AA-CubeSat-Team/soci_img/src-no_thumbnail/README.md

# Current version v0.0.0

## Release History
