AA-CubeSat-Team/soci_img/FreeVector-Color-Grid.jpg

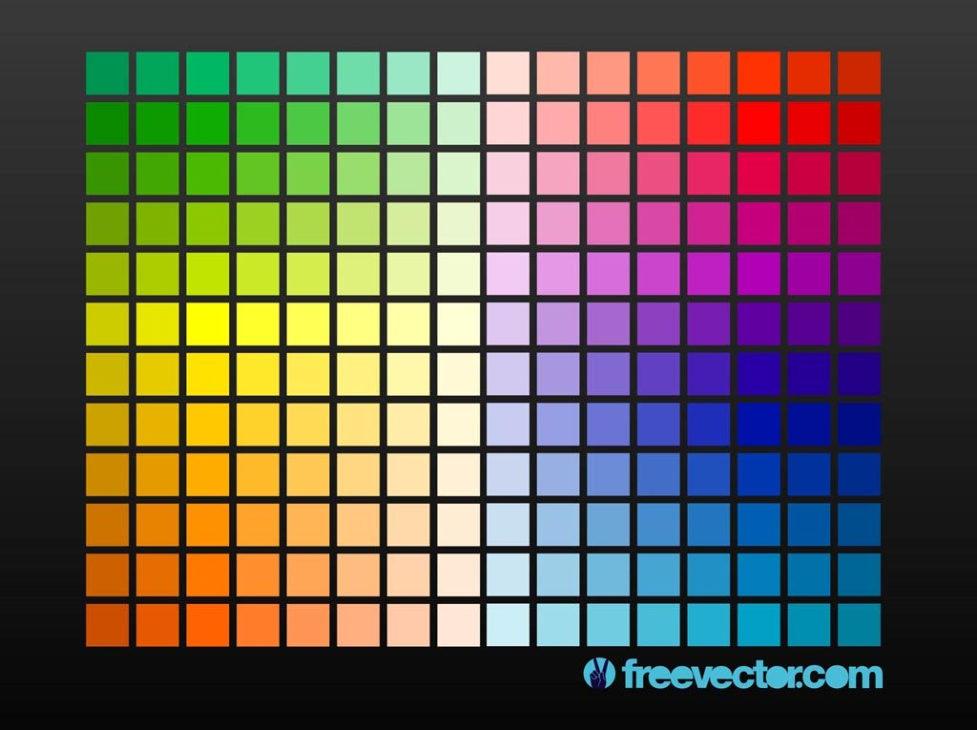
FreeVector-Color-Grid.jpg
