AA-CubeSat-Team/soci_img/misc/Initialization_Flowchart.png

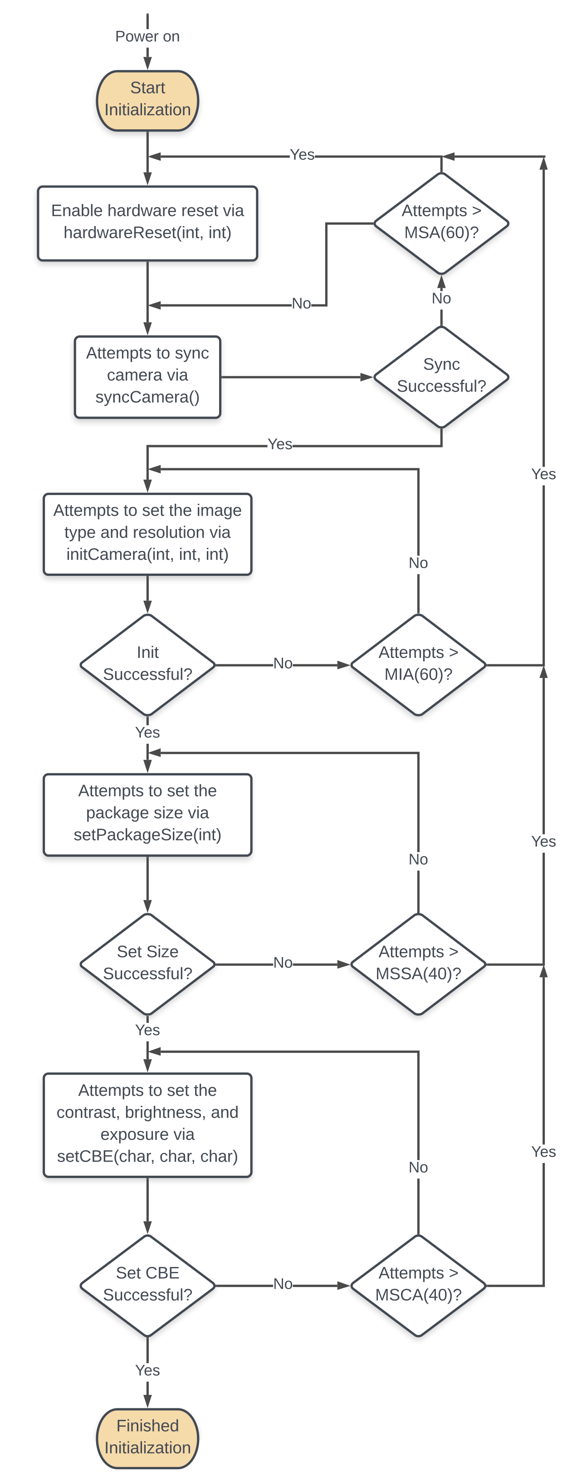
misc/Initialization_Flowchart.png
