AA-CubeSat-Team/soci_img/misc/Runtime_Flowchart.png

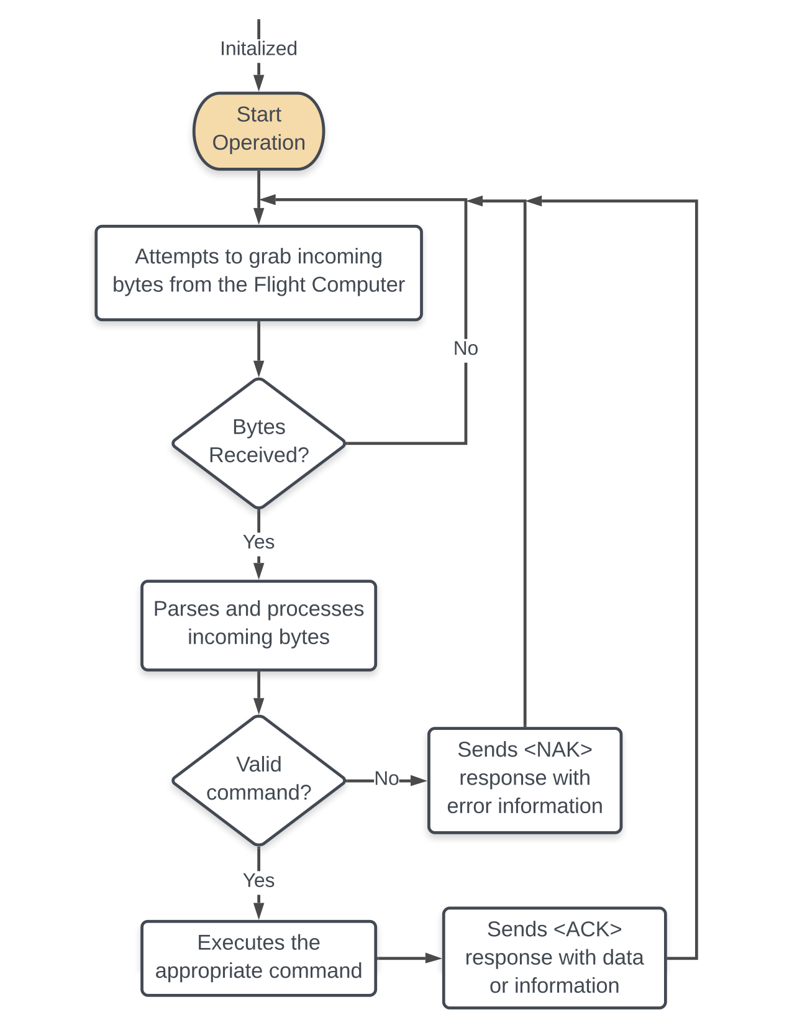
misc/Runtime_Flowchart.png
