AA-CubeSat-Team/soci_img/Testbed/Cura-15.04.5-and-plugins-CraftBot-1-6-2016/craftbot_platform.stl

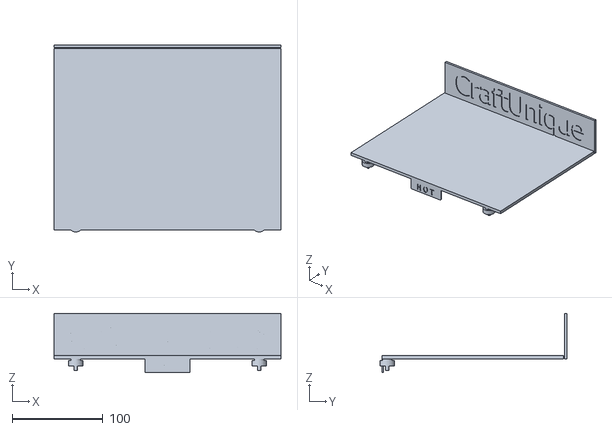
[picture p6: CAD file, 2020-05-07]
Testbed/Cura-15.04.5-and-plugins-CraftBot-1-6-2016/craftbot_platform.stl
250.0 x 206.0 x 65.0
