AA-CubeSat-Team/soci_img/history/Byte_Array_To_Image/test-PRISM-DESKTOP.txt

FFD8FFDB0084000D09090B0A080D0B0A0B0E0E0D0F13201513121213271C1E
17202E2931302E292D2C333A4A3E333646372C2D405741464C4E525352323E
5A615A50604A51524F010E0E0E131113261515264F352D354F4F4F4F4F4F4F
4F4F4F4F4F4F4F4F4F4F4F4F4F4F4F4F4F4F4F4F4F4F4F4F4F4F4F4F4F4F4F
4F4F4F4F4F4F4F4F4F4F4F4FFFC401A2000001050101010101010000000000
0000000102030405060708090A0B100002010303020403050504040000017D
01020300041105122131410613516107227114328191A1082342B1C11552D1
F02433627282090A161718191A25262728292A3435363738393A4344454647
48494A535455565758595A636465666768696A737475767778797A83848586
8788898A92939495969798999AA2A3A4A5A6A7A8A9AAB2B3B4B5B6B7B8B9BA
C2C3C4C5C6C7C8C9CAD2D3D4D5D6D7D8D9DAE1E2E3E4E5E6E7E8E9EAF1F2F3
F4F5F6F7F8F9FA010003010101010101010101000000000000010203040506
0708090A0B1100020102040403040705040400010277000102031104052131
061241510761711322328108144291A1B1C109233352F0156272D10A162434
E125F11718191A262728292A35363738393A434445464748494A5354555657
58595A636465666768696A737475767778797A82838485868788898A929394
95969798999AA2A3A4A5A6A7A8A9AAB2B3B4B5B6B7B8B9BAC2C3C4C5C6C7C8
C9CAD2D3D4D5D6D7D8D9DAE2E3E4E5E6E7E8E9EAF2F3F4F5F6F7F8F9FAFFC0
00110801E0028003012200021101031101FFDA000C03010002110311003F00
D3029714A2940AF2CF60402976D28A5A06376D2629F498A0686E28DB4EC518
A06376F346296971CD0862628DB4EC518A0040BCD2E2940A5C5031314B8A5E
F4B40098A5028A281062968A2800A5A28A620C52E39A28A4014639A297BD00
18A00A5A4A0618A314B4500348A4C53F1498A62198A4229C692900DC534AD4
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
7D0D64DC0AE881C954A869B4E34DAD91CC21A4A5A4A620A28A4A042D145140
C28A28A007A1E6AF5BB722B3C75AB50B74A8923483D4DBB67E056A40DC562D
B3D6A5BBF22B9A477419AB135594AA3137356D0D66CD09B3C535A941A43D2A
4085EABBD587AAEF5422B4B5524EF56E4AA9277AA4432A4BDEAA4B56E4AA92
D6913291FFD951
