AA-CubeSat-Team/soci_img/history/Byte_Array_To_Image/test.txt

FFD8FFDB0084000D09090B0A080D0B0A0B0E0E0D0F13201513121213271C1E
17202E2931302E292D2C333A4A3E333646372C2D405741464C4E525352323E
5A615A50604A51524F010E0E0E131113261515264F352D354F4F4F4F4F4F4F
4F4F4F4F4F4F4F4F4F4F4F4F4F4F4F4F4F4F4F4F4F4F4F4F4F4F4F4F4F4F4F
4F4F4F4F4F4F4F4F4F4F4F4FFFC401A2000001050101010101010000000000
0000000102030405060708090A0B100002010303020403050504040000017D
01020300041105122131410613516107227114328191A1082342B1C11552D1
F02433627282090A161718191A25262728292A3435363738393A4344454647
48494A535455565758595A636465666768696A737475767778797A83848586
8788898A92939495969798999AA2A3A4A5A6A7A8A9AAB2B3B4B5B6B7B8B9BA
C2C3C4C5C6C7C8C9CAD2D3D4D5D6D7D8D9DAE1E2E3E4E5E6E7E8E9EAF1F2F3
F4F5F6F7F8F9FA010003010101010101010101000000000000010203040506
0708090A0B1100020102040403040705040400010277000102031104052131
061241510761711322328108144291A1B1C109233352F0156272D10A162434
E125F11718191A262728292A35363738393A434445464748494A5354555657
58595A636465666768696A737475767778797A82838485868788898A929394
95969798999AA2A3A4A5A6A7A8A9AAB2B3B4B5B6B7B8B9BAC2C3C4C5C6C7C8
C9CAD2D3D4D5D6D7D8D9DAE2E3E4E5E6E7E8E9EAF2F3F4F5F6F7F8F9FAFFC0
00110801E0028003012200021101031101FFDA000C03010002110311003F00
F4FA28A2800A28A2B3A92B22A2AEC8AE24D9113F85725ABDC9C919EFDBD6B7
F549C2AE01FC2B8EBF94C92E3B77AE093BB3D1A71B2293530D486A3348D061
A61A79A61A0069A4C52E297140C4C52E29714B8A431B4629D8A00A06007353
44BCD31579AB502027D85022CC09FE7D2AEC69CF4A8E08F8AB9127B52403E3
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
1A53494009494EA4A6034D253A90D00368A5C5262801314629D8A4A0042293
14EC52628013149B69D8A2980DC73498A7D25201BB6908A7D21A60308A61A7
9A61A018C34869D494086114D22A422986980C34D6A79A6374A604125529BA
D5D90F06A84C6A908AAE79A60EB4AE79A45EB56664E9D2A74A812A75A965A1
F45149480DC84722AF403A554847157E11C9ACD8CB510E2AC254318A9D0503
244A99454682A65A621EB520A60A78A042D2D252D020A4A5A280129294D250
3129296928010D21A5A4A004A434B4D340C434D34EA69A431A6929690D0021
A69A753681894DA752520129296928012929692801292968340094869690D0
021A4EF4A692801290D2D250034D2538D34D0025252D252010D21A5A434009
494BDE92801292968A6034D14B49400949DE9D494009452D140098A4C53A92
80128A5A28010D262968A006D069D4D34C08DAA363523542C68420A2901A5A
6021A434E34C3D684034D46D529A89E988AF2F7ACF98F26AF4C7822A84E792
2AE2265563CD09D691A953AD591D49D2A75A812A65E9505A1F499A28A407FF
D9
