AA-CubeSat-Team/soci_img/misc/uCamIII_Size_Test.xlsx

Sheet: JPG_640x480
6350
28320
22068
16022
19278
27088
13040
6496
8328
23576
22562
6198
8100
6602
26176
29146
27388
24208
25874
17598
6198 | MIN
29146 | MAX
18220.9 | AVG
8570.012307 | STDEV

Sheet: JPG_160x128
4276
4518
4462
3772
3596
3100
1866
2228
1348
1278
1250
3922
3972
4344
4168
4790
3808
4862
4104
4626
1250 | MIN
4862 | MAX
3514.5 | AVG
1225.344098 | STDEV
