AA-CubeSat-Team/soci_img/history/ArduinoTest_2/output1(first ever picture).jpg

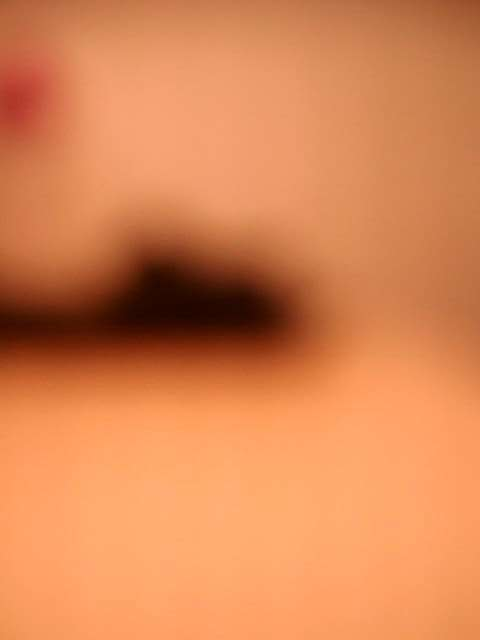
history/ArduinoTest_2/output1(first ever picture).jpg
