AA-CubeSat-Team/soci_img/history/ArduinoTest_2/output2(first ever humanoid).jpg

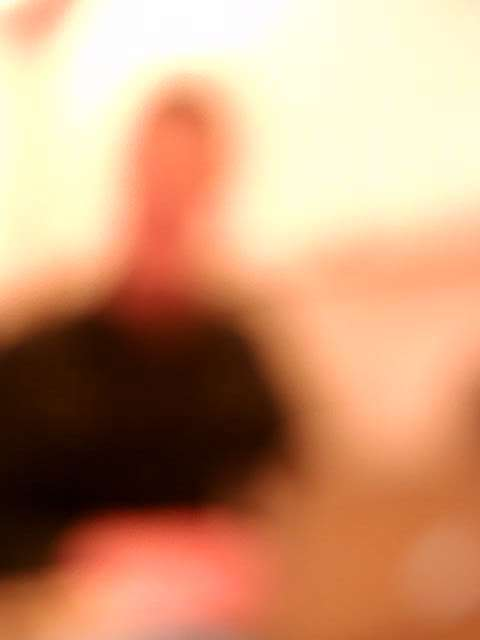
history/ArduinoTest_2/output2(first ever humanoid).jpg
