AA-CubeSat-Team/soci_img/history/ArduinoTest_2/output3(lens fully extended).jpg

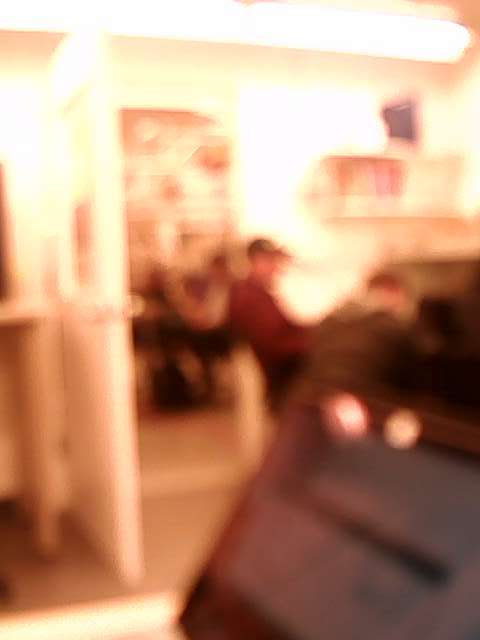
history/ArduinoTest_2/output3(lens fully extended).jpg
