AA-CubeSat-Team/soci_img/history/Byte_Array_To_Image/README.md

# Byte_Array_To_Image
Folder containing files to convert byte arrays to images

```
To use the 'Convert.jar' use command:
java -jar Convert.jar <file name>

For example:
java -jar Convert.jar test_picture.txt

The first bytes of the data should be FFD8 and the last/second to last should be FFD9
```
