AA-CubeSat-Team/soci_img/history/Byte_Array_To_Image/output3.jpg

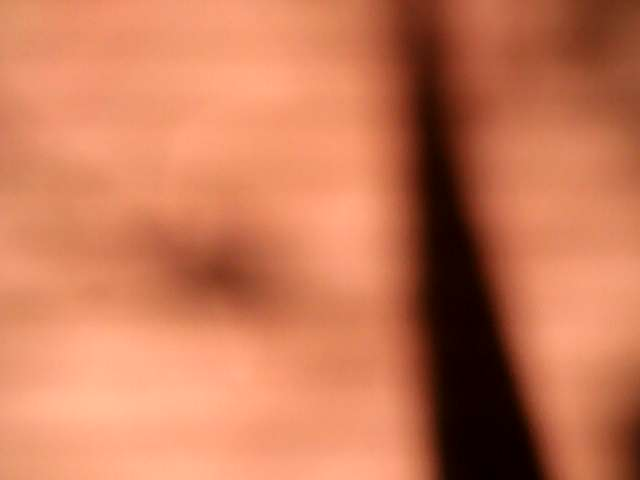
history/Byte_Array_To_Image/output3.jpg
