AA-CubeSat-Team/soci_img/software_serial_test/tx_board/tx_board.ino

#include <SoftwareSerial.h>

#define RX_PIN 10
#define TX_PIN 11

#define BAUDRATE 9600

SoftwareSerial mySerial(RX_PIN, TX_PIN);

void setup() {
  // put your setup code here, to run once:
  // Open serial communications and wait for port to open:
  Serial.begin(9600);

  // set the data rate for the SoftwareSerial port
  mySerial.begin(BAUDRATE);
}

char buf[5];
void loop() {
  if (Serial.available() > 0) {
     Serial.readBytes(buf, 5);
     mySerial.write(buf, 5);
     memset(buf, 0, 5);
  }
}
