AA-CubeSat-Team/soci_img/history/ArduinoTest_Unit/HW_UART_Receiver_Test/HW_UART_Receiver_Test.ino

/**
 * Tests the data transmission via UART as receiver device
 * (Hardware Serial)
 */

/* Pin Assignments */
const static int txPin = 1;
const static int rxPin = 0;

/* Class constants */
const static unsigned int SECOND = 1000;
const static unsigned int BYTES_LIMIT = 30000;
const static unsigned int PACKET_SIZE = 32;
const static byte ACK_BYTE = 0x00;

/**
 * Recommended testing baud rates are:
 * 300, 600, 1200, 2400, 4800, 9600, 14400, 
 * 19200, 28800, 38400, 57600, or 115200
 */
const static unsigned long BAUD_RATE = 115200; 

void setup() {
  Serial.begin(BAUD_RATE, SERIAL_8N1);
  while (!Serial) {}

  int bytesReceived = 0;
  unsigned long t_start = millis();
  while(bytesReceived < BYTES_LIMIT) {
    Serial.write(ACK_BYTE);
    delay(3);
    for(int i = 0; i < PACKET_SIZE; i++) {
      byte incoming = Serial.read();
      if(incoming != (byte)bytesReceived) {
        if(bytesReceived == BYTES_LIMIT) {break;}
        Serial.print("Mismatch! Expected: "); Serial.print(bytesReceived);
        Serial.print(" Received: "); Serial.println(incoming);
        while(1) {};
      }
      bytesReceived++;
    }
  }
  Serial.println("All successful");
  Serial.print("Time used in seconds: "); Serial.println((millis() - t_start) / SECOND);
}

void loop() {}
