AA-CubeSat-Team/soci_img/tests/v1.1.0-probing/0x01_testTakePicture.ino

/**
 * Tests the TAKE_PICTURE command, which saves the picture and
 * thumbnail to the SD card. Will require manual verification.
 * (Systems need to be reset since test debug with serial)
 */
void testTakePicture() {
  /* Checking error detection of INVALID_SLOT */
  Serial.println(F("--beginning testTakePicture--"));
  //checkInvalidSlot(TAKE_PICTURE);
  /* Checking reponse of valid command */
  for(byte i = 0x00; i < IMAGES_COUNT; i++) {
    // give 3 trails maximum for each slot
    for (int trail = 0; trail < 3; trail++) {
      memset(responseBytes, 0, MAX_RESPONSE_BYTES);
      sendCommand(TAKE_PICTURE, i);
      while(mySerial.available() == 0); // wait for response
      mySerial.readBytes(responseBytes, MAX_RESPONSE_BYTES);
      if(responseBytes[0] != ACK ||
         responseBytes[1] != TAKE_PICTURE || 
         responseBytes[2] != i) {
        Serial.print(F("\nFAIL: Did not give proper response when slot = ")); Serial.println(i);
        Serial.print(F("Received: "));
        for(int j = 0; j < MAX_RESPONSE_BYTES; j++) {
          Serial.print("0x"); Serial.print(responseBytes[j], HEX); Serial.print(" ");
        }
        //if (trail == 2) while(1);// failed to take picture at slot within 3 trails
        
      } else {
         break;  
      }
    }
    delay(1000); 
  }
  /* Success */
  Serial.println("-- takePicture() test function complete--");
  Serial.println("Requires manual checking: Verify files in SD card");
}
