AA-CubeSat-Team/soci_img/history/ArduinoTest_3/CommandSet.h

/*
 * Compiler linkage for public function declared in 
 * CommandSet.c
 * 
 */

#ifndef __COMMANDSET_H__
#define __COMMANDSET_H__

// Compiler Linkage
#ifdef __cplusplus
extern "C" {
#endif

// Function prototypes
bool syncCamera();
bool resetCamera(char resetType);
bool initializeCamera(char format, char rawResolution, char jpgResolution);
bool setPackageSize(unsigned int packageSize);
bool setCBE(char contrast, char brightness, char exposure);
bool setSleepTime(char seconds);
bool takeSnapshot(char snapshotType);
bool takePicture(char pictureType);

#ifdef __cplusplus
} // extern "C"
#endif

#endif /* __COMMANDSET_H__ */
