AA-CubeSat-Team/soci_img/(commit log)

2019-04-26 Initial Arduino Testing
2019-05-24 Working unstable prototype
2019-06-06 Test_3 has some bugs
    [ArduinoCommunication.ino, Arduino_Test_3.ino, uCamIII.ino]
2019-07-18 converted flowchart into png
2019-07-18 Added flowchart
2019-07-19 Fixed flowchart
2019-07-20 Reorganized for arduino
2019-07-20 Renamed for arduino pro mini
2019-08-18 renamed flowcharts
2019-08-18 updated flowchat path
2019-08-22 modify src based on redesign
    [ArduinoCommunication.ino, SystemConstants.h, uCamIII.h, uCamIII.ino]
2019-08-22 remove Arduino_Test_4 as unnecessary
2019-08-23 Implement stage transmit of data for external device
2019-08-23 Implement data transmition in stages
2019-08-26 Add analysis for picture size
    [uCamIII_Size_Test.xlsx]
2019-08-26 Move flowchats to misc folder
2019-08-26 Fix flowcharts path
2019-08-26 Reformat flowchart
2019-09-04 Fix bug in receiveAckCommand(char)
    [ArduinoCommunication.ino, uCamIII.ino]
2019-09-12 Fix bug in CHECK_STATUS command
    [CommandInterpreter.ino]
2019-09-17 Update with potential bug
    [CommandInterpreter.ino, SystemConstants.h, uCamIIICommunication.ino]
2019-09-18 Fixed bug that halts readData()
    [ExternalCommunication.ino, SDAccess.ino, uCamIIICommunication.ino]
2019-09-23 Add empty timing chart
    [v1.0.0-timing.xlsx]
2019-09-23 Update: TAKE_PICTURE bug persists
    [CommandInterpreter.ino, CommandSet.ino, ExternalCommunication.ino, SDAccess.ino, SystemConstants.h, uCamIII.h, uCamIII.ino]
2019-09-25 Fix transmission issue for no_thumbnail
    [CommandInterpreter.ino, src-no_thumbnail.ino, uCamIII.ino]
2020-05-07 Added probing under test files
    [craftbot_platform.stl]
2020-05-15 Updated readme pin connections
2020-11-02 added 4DSystems camera demo software under tests
2020-11-21 Debug print statements
2020-11-26 added camera reset before attempting to initialize for src_no_thumbnail
    [ArduinoCommunication.ino, ArduinoTest_3.ino, CommandSet.ino, ExternalCommunication.ino, src-no_thumbnail.ino, uCamIIICommunication.ino]
2021-01-14 pin fix
2021-04-07 functionality for sd card and camera
2021-05-19 fixed interpret command (somehow)
    TODO: fix commandInterpreter
    [CommandInterpreter.ino, src-with_thumbnail.ino, tx_board.ino, v1.1.0-probing.ino]
2021-05-29 fixed serial probing issue
    On the src_withthumbnail board, Serial port is connected both via USB and UART pin, when actually using it, if do not use "Serial,print()" on thumbnail board, as it will conflict with the UART hardware pin.
    Minimal requirement: Since there are some setup prints in the thumbnail board, either get rid of all print statements, or connected the board to usb so exhaust the UART buffer
    [0x00_testCheckStatus.ino, CommandInterpreter.ino, ExternalCommunication.ino, SDAccess.ino, src-with_thumbnail.ino, uCamIII.ino, v1.1.0-probing.ino]
2021-06-08 successfully transmitted img, only missing remainning bytes (not implemented yet)
    [0x05_testGetPicture.ino, SDAccess.ino]
2021-06-09 Successfully transmitted image to probing device
    TODO:
    1) test lost package
    2) dump image file to txt file and automatically convert image
2021-06-25 setContrast working but glitchy, might need to mess with the serial monitor to exhaust buffer or somethign
    [0x02_testGetThumbnailSize.ino, 0x03_testGetPictureSize.ino, 0x05_testGetPicture.ino, 0x06_testSetContrast.ino, CommandInterpreter.ino]
2021-06-25 camera setting working
    glitchy sometimes, also different setting produces similar image
    [0x07_testSetBrightness.ino, 0x08_testSetExposure.ino, CommandInterpreter.ino, v1.1.0-probing.h]
2021-06-29 unit test done but glitchy
    [0x09testSetSleepTime.ino, CommandInterpreter.ino]
2022-02-15 for CIA board
2022-04-06 serial prints uncommented
